crobarcro/SmartHubOSS/README.md

# SmartHub
## A fully transparent, bidirectional Analog-Digital Bluetooth Bridge for Siemens/BONUS wind turbines
### Developed for all AN-BONUS (Siemens) 1.3MW and 2MW WTC2 wind turbines, easily adaptable to others

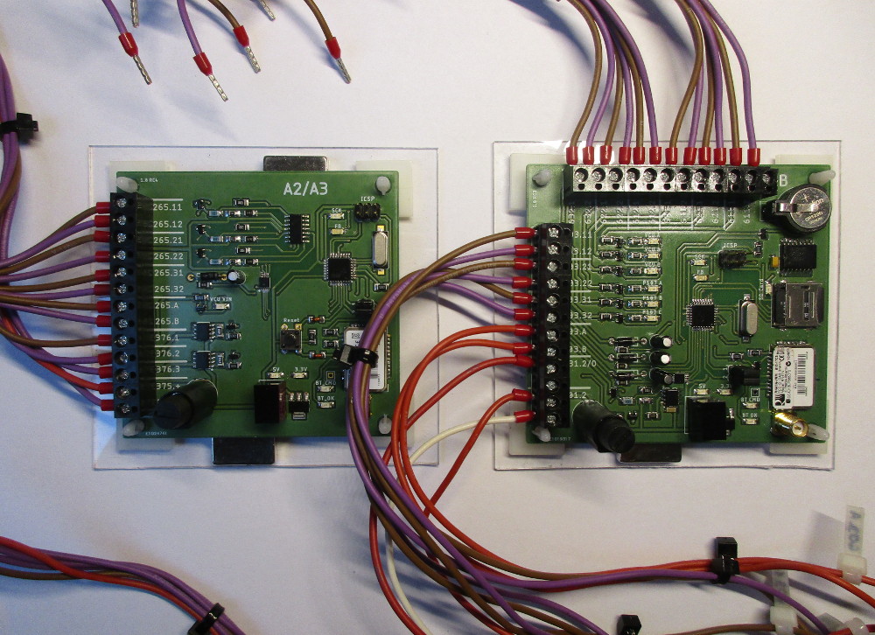
[picture p1: media/SmartHub.jpg]
SmartHub preview


## Description:

- stable and (in the case of our old turbines) more reliable Bluetooth connection;
- translate all signals to digital, transmit and then recreate them on the other side;
- watch every single signal and log all errors on a SD card;
- even more precise than the original transmission;
- a very extensible software, allowing to watch for much more complicated conditions;
- enormously reducing the costs of repairing a slippery ring;
- enormously reduction in time when searching for a problem's cause;
- the error log can be read directly from the SD, or through an Android app.

## Legal
- Use this at your own risk.
- I live and work in Germany. According to the <a href="https://de.wikipedia.org/wiki/Arbeitnehmererfindung">german law</a> I received permission from my employer to do whatever I please with my creation;
- My work is released under [MIT](LICENSE) license.

## Credits
This work uses the following:

- The C++ firmware is build with <a href="https://www.arduino.cc/en/Main/FAQ">Arduino</a>. Licensed under: <a href="https://github.com/arduino/Arduino/blob/master/license.txt">LGPL</a>;
- Also using some Arduino libraries (see the code), <a href="https://github.com/adafruit/RTClib">RTClib</a> and <a href="https://forum.arduino.cc/index.php?topic=51842.0">mcp4728</a>;
- Without the countless contributions of the friendly folk at <a href="https://stackoverflow.com">stackoverflow</a> and <a href="https://edaboard.com">edaboard</a> nothing of this would be possible.

## 
<p style="text-align: right">
    <a href="https://vlzware.com">Vladimir Zhelezarov</a> © 2018
</p>
