crobarcro/SmartHubOSS/media/1_A6_.jpg

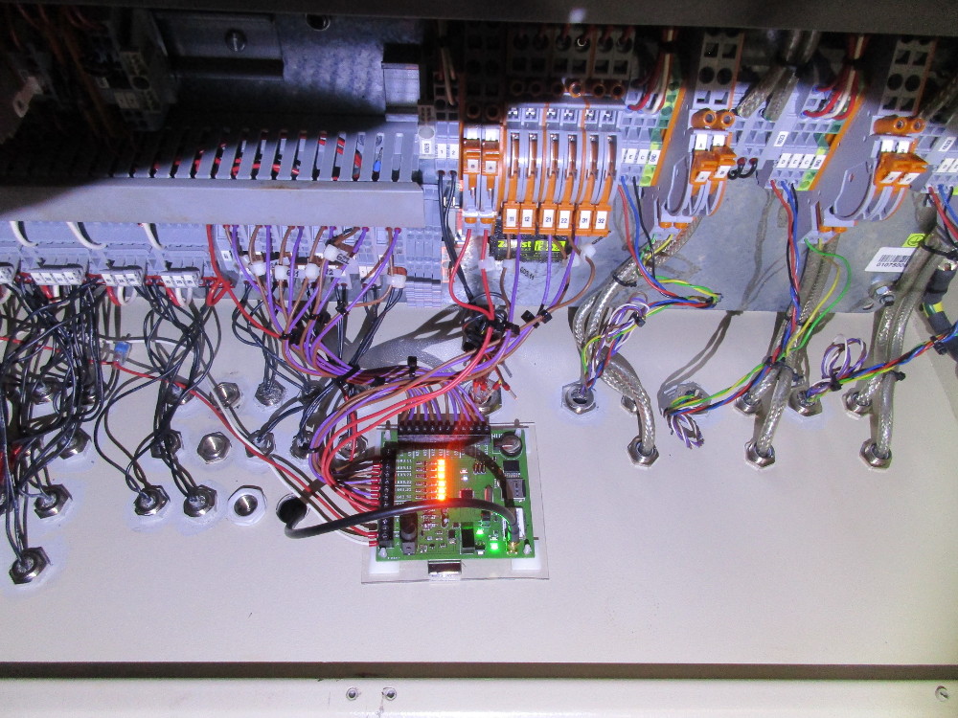
media/1_A6_.jpg
