crobarcro/SmartHubOSS/media/2_A2A3_.jpg

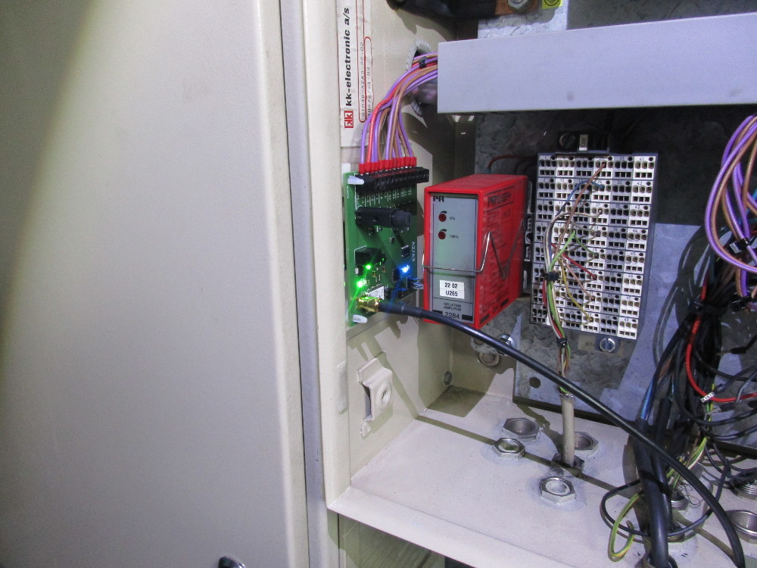
media/2_A2A3_.jpg
