crobarcro/SmartHubOSS/circuit_plans/A3_1.0.pdf

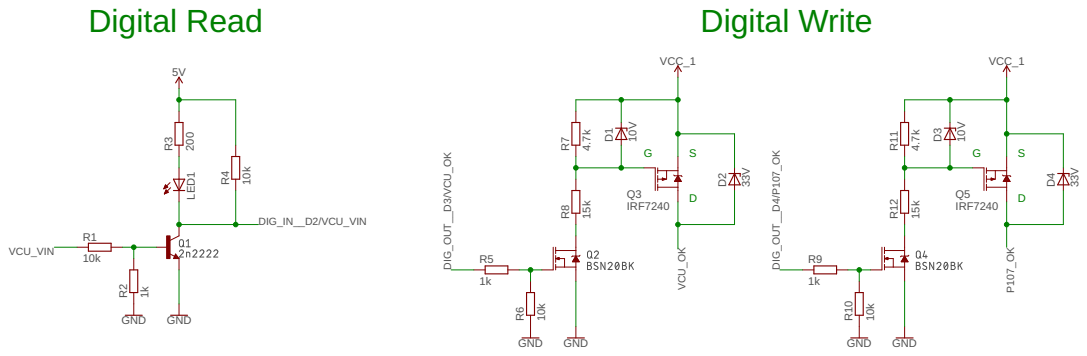
[picture p4: page 1]

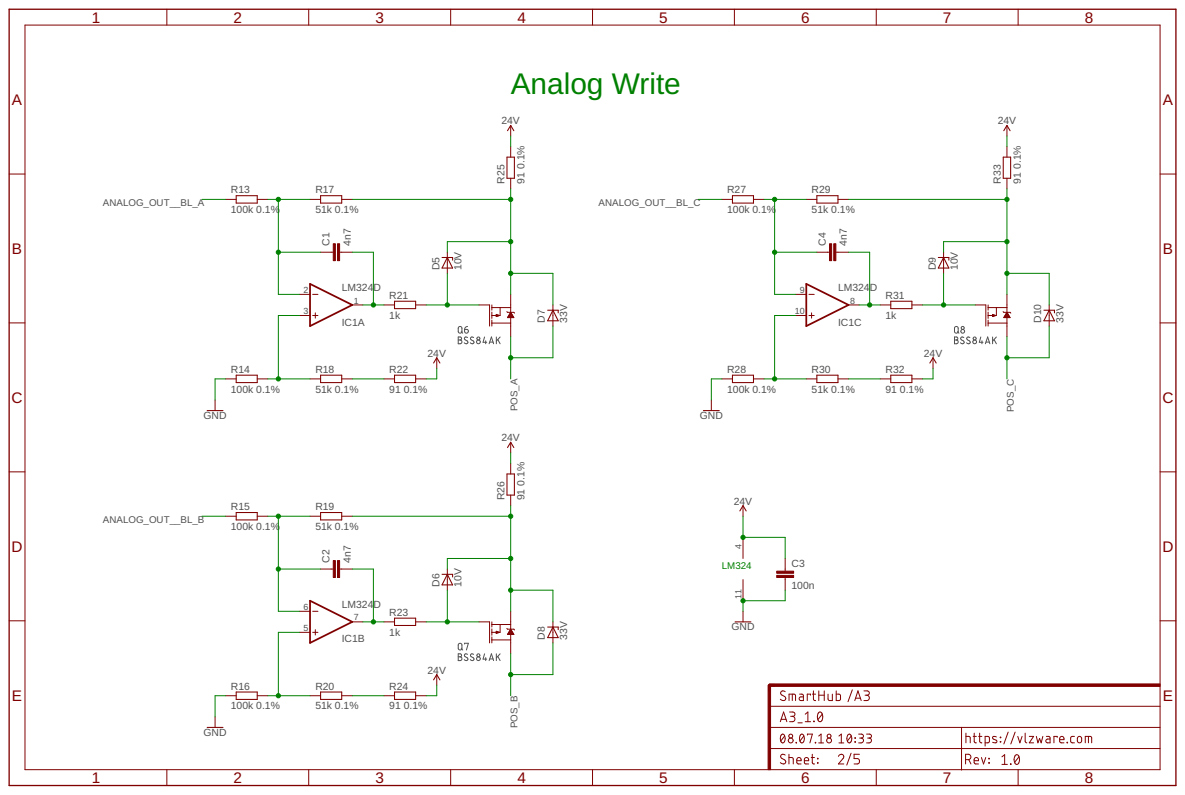
[picture p5: page 2]

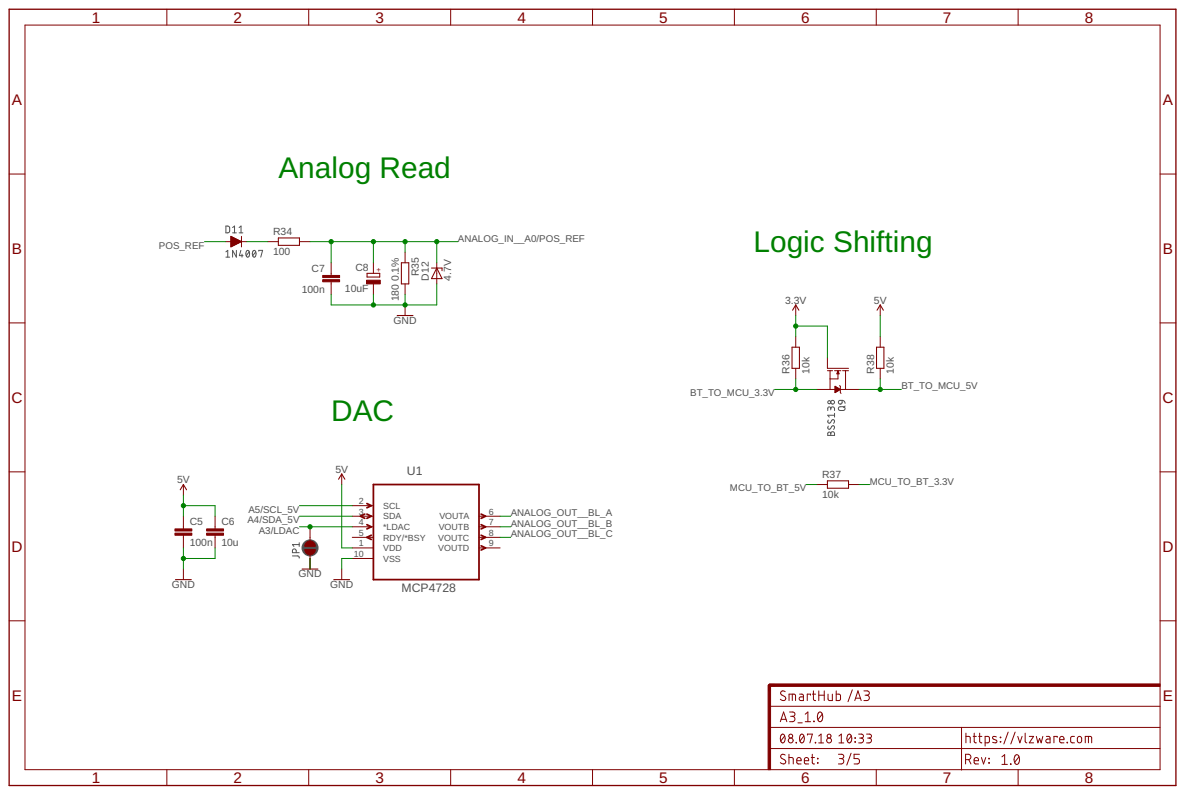
[picture p6: page 3]

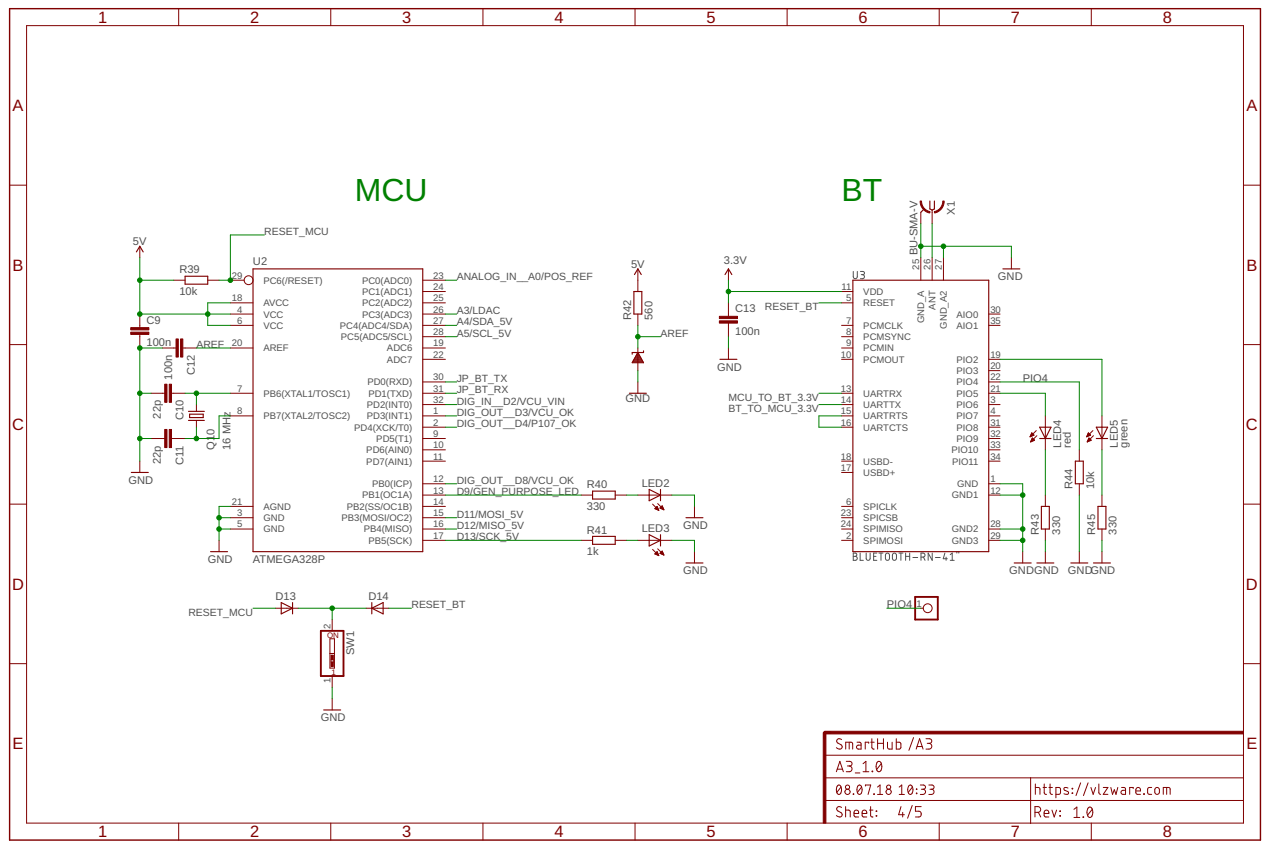
[picture p7: page 4]

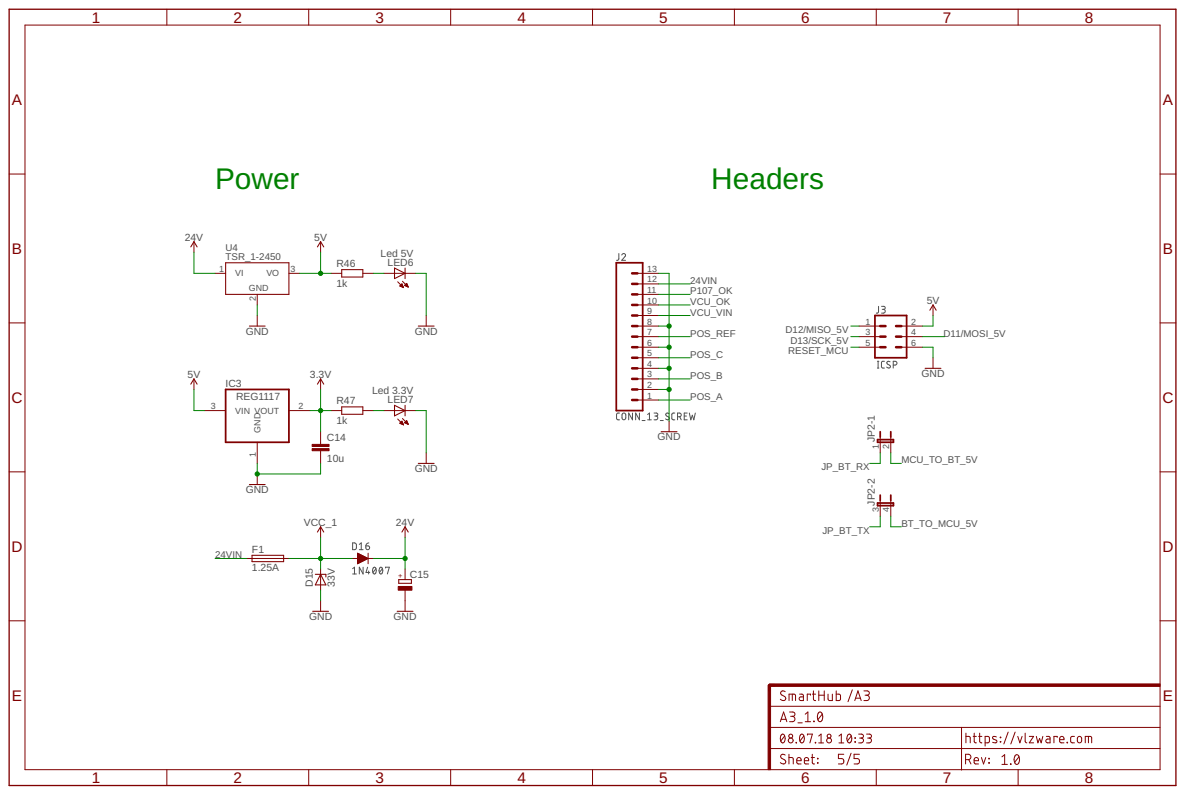
[picture p8: page 5]
