crobarcro/SmartHubOSS/circuit_plans/HUB_1.0.pdf

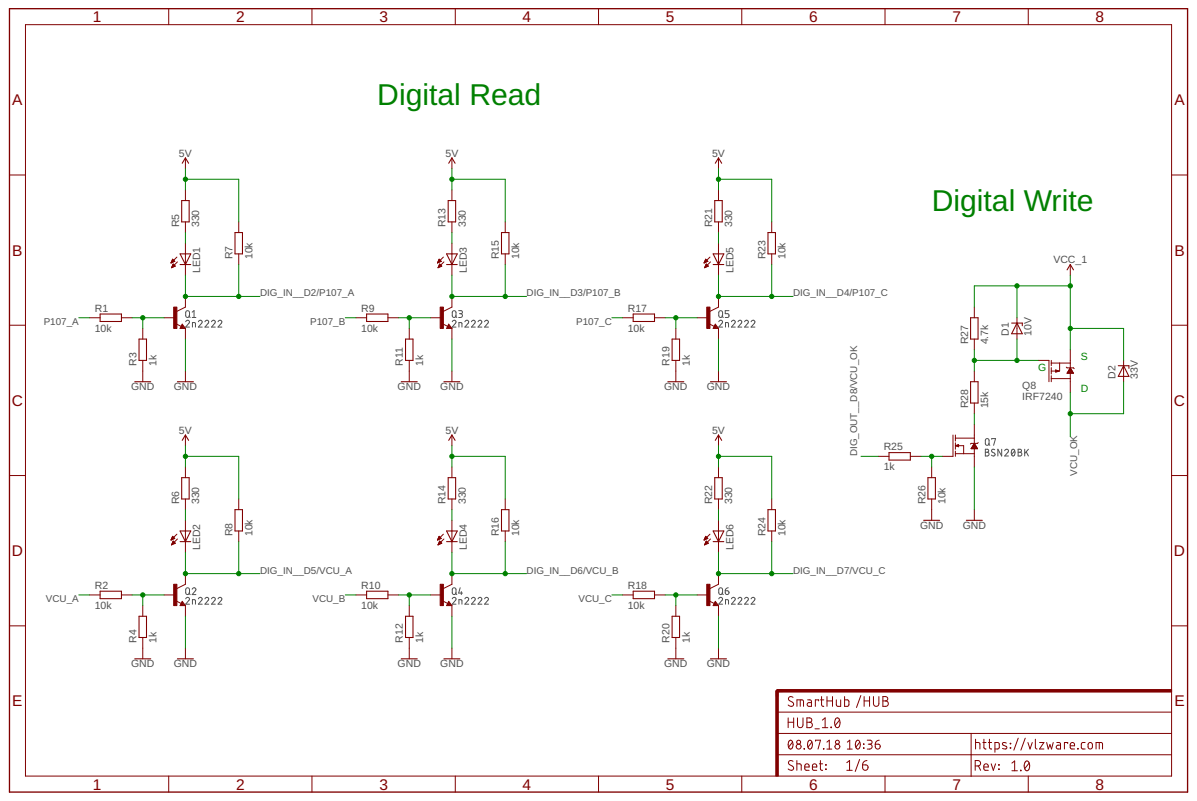
[picture p9: page 1]

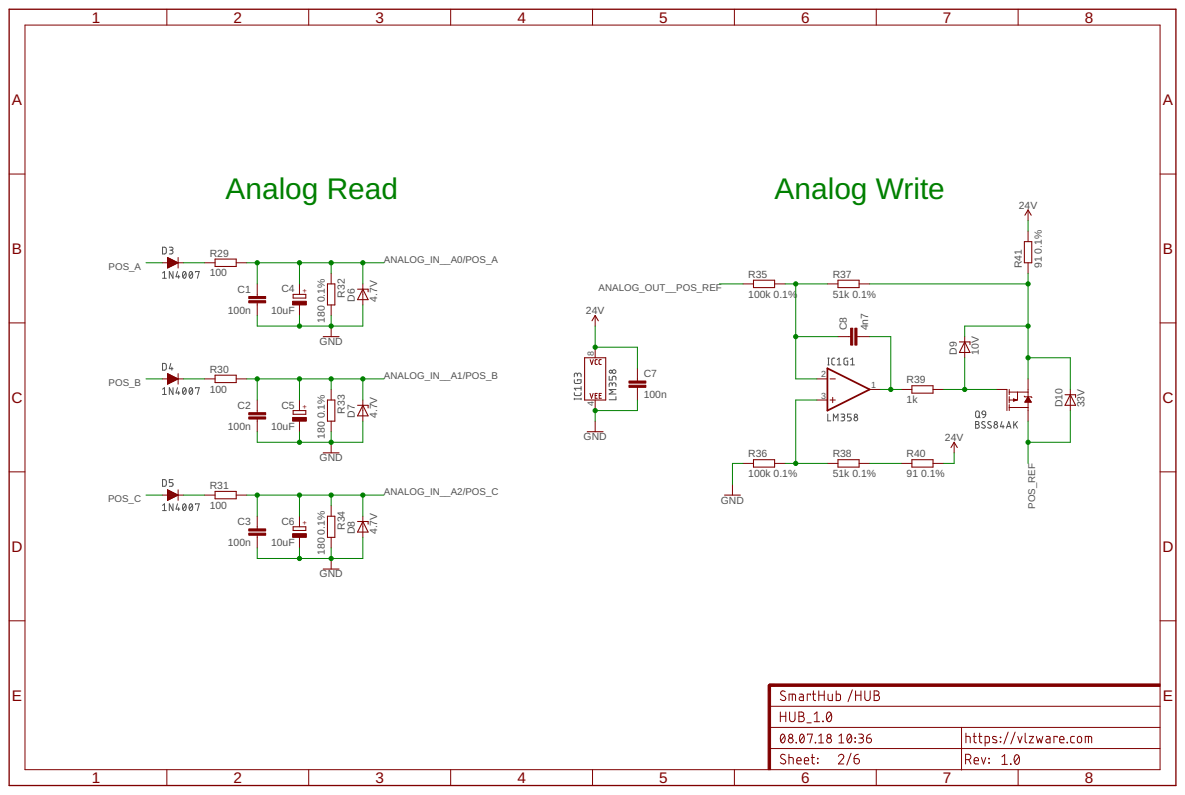
[picture p10: page 2]

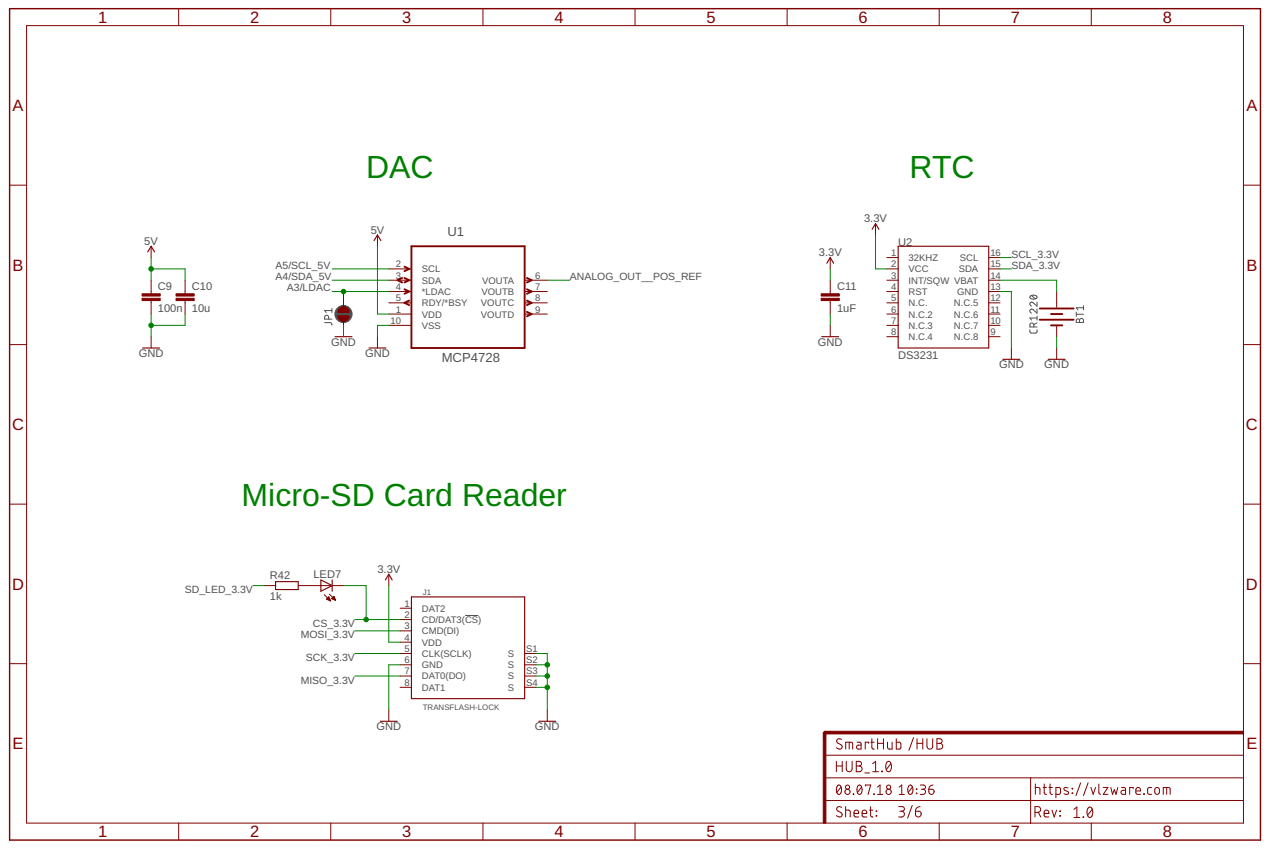
[picture p11: page 3]

Micro-SD Card Reader

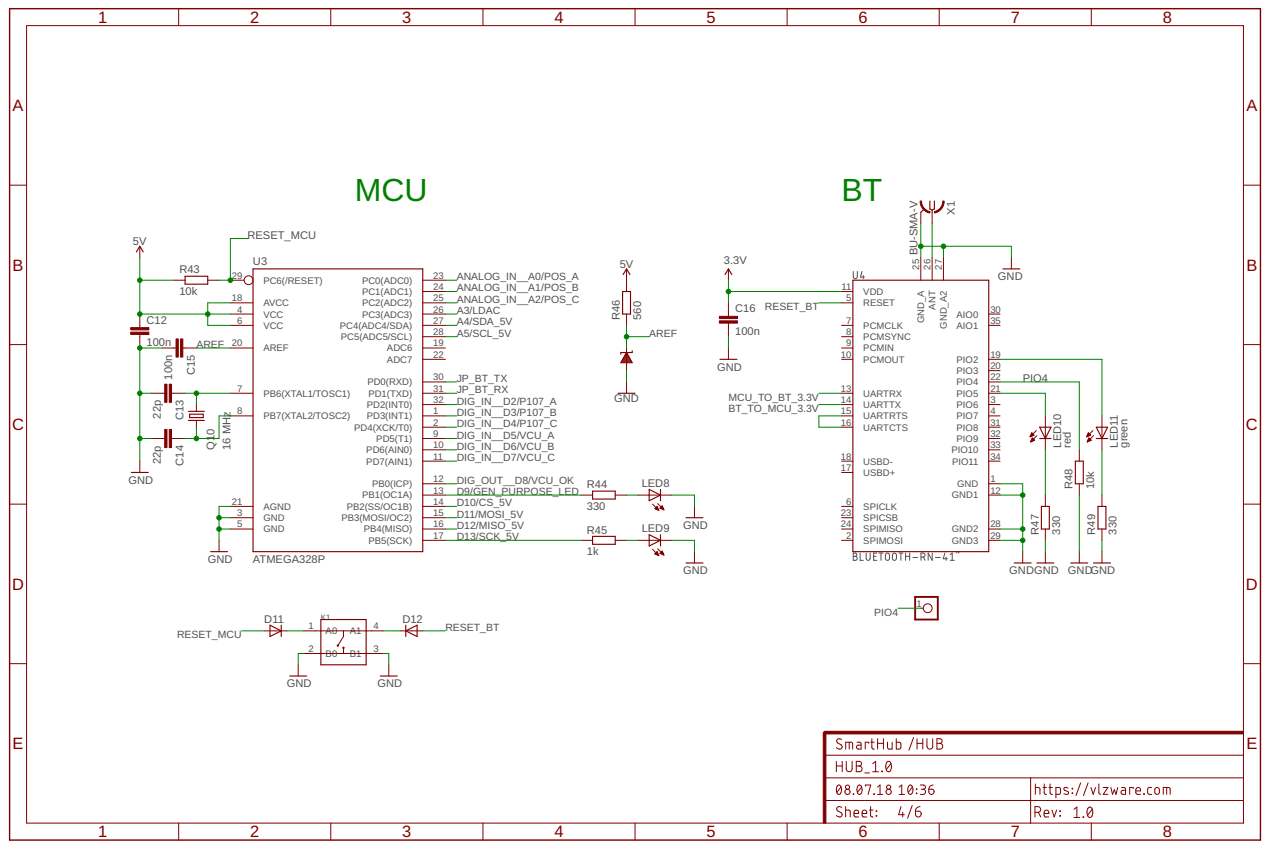
[picture p12: page 4]

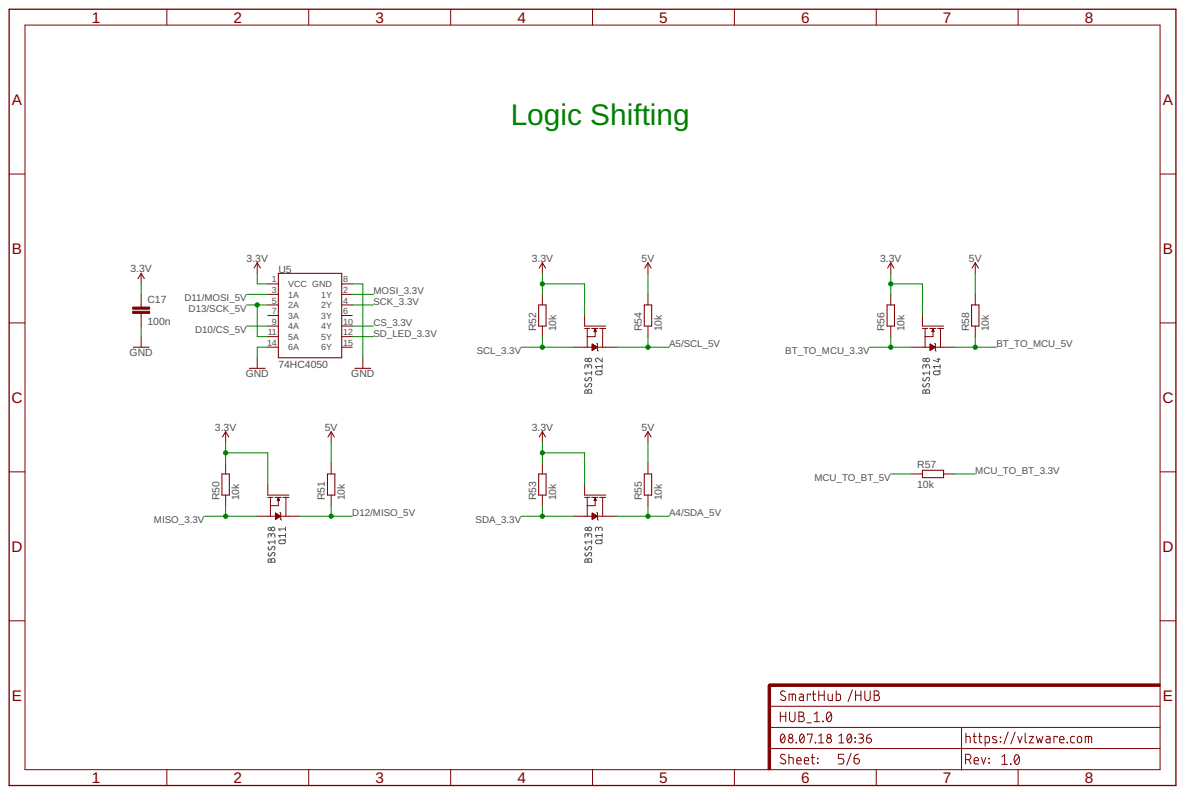
[picture p13: page 5]

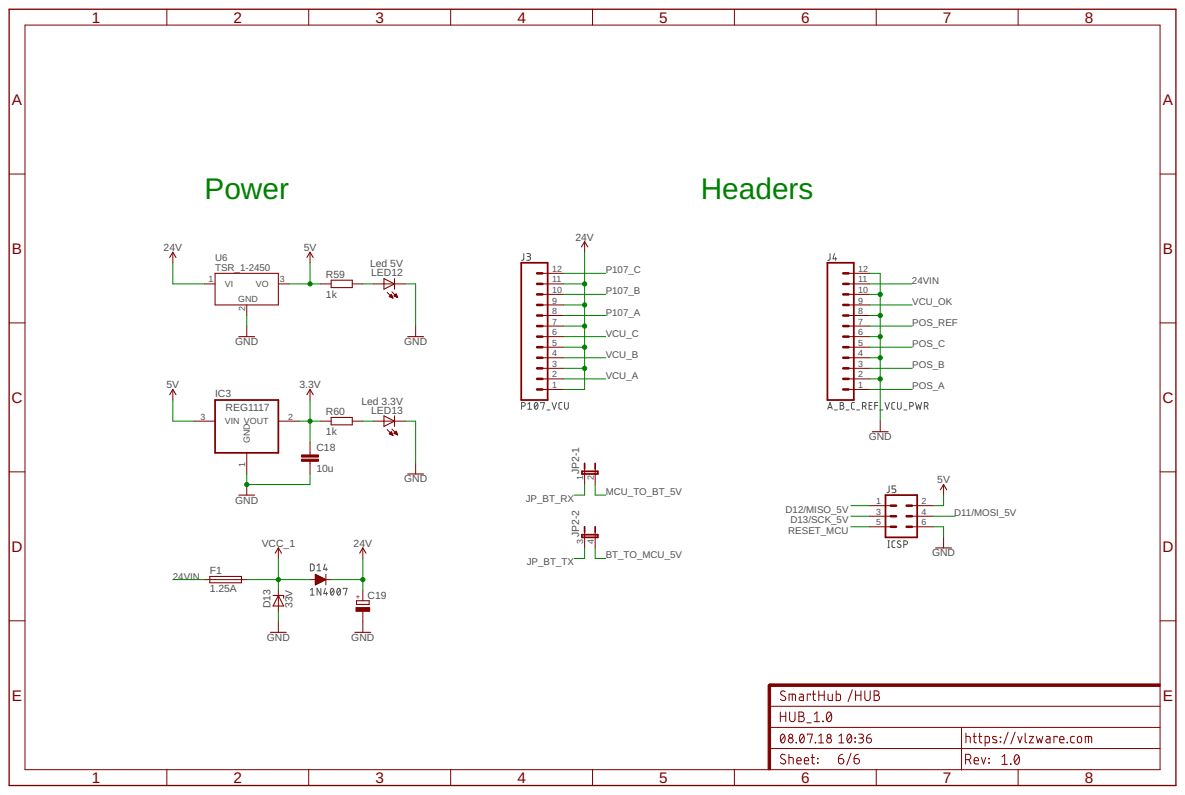
[picture p14: page 6]
